jtjtjasontan/Breath_Rate_Estimator/complete_circuit.asc

C1: cap; 100n
C2: cap; 100n
C3: cap; 100n
C4: cap; 100n
C5: cap; 100n
C_Diff: cap; 10µ
CB1: cap; 10µ
R1: res; 10k
R2: res; 10k
R3: res; 470k
R4: res; 100
R5: res; 100
R6: res; 1k
R7: res; 1k
R8: res; 1k
Rdiv1: res; 2.2k
Rdiv2: res; 2.2k
Rdiv3: res; 100
Rdiv4: res; 100
Rdiv5: res; 1k
Rdiv6: res; 1k
Rdiv7: res; 100
RF1: res; 470k
RF2: res; 1k
RF_Diff: res; 100k
RL1: res; 2.2k
RL2: res; 2.2k
Rref1: res; 10k
Rref2: res; 1k
Rubber: res; {R_rubber}
Thermistor: res; {R_therm}
U1: TLV9054
U2: TLV9054
U3: TLV9054
U4: TLV9054
U5: TLV9054
V1: voltage; 3.3
Vref1: voltage; 3.3
Vref2: voltage; 3.3
Named nets: 0, Vcc, V_STM_A0, V_therm, V_rubber, V_STM_A1
.tran 20
Thermistor Signal Conditioning Circuit
Conductive Rubber Signal Conditioning Circuit
Ref. Voltage Divider
Ref. Voltage Divider
Voltage Buffer
Voltage Buffer
Difference Amplifier
Difference Amplifier
Differential Amplifier
Thermistor and Conductive Rubber Setup
