jtjtjasontan/Breath_Rate_Estimator/main.c

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

/* Includes ------------------------------------------------------------------*/
#include "main.h"

/* USER CODE BEGIN Includes */
#include <stdio.h>   /* snprintf */
/* USER CODE END Includes */

ADC_HandleTypeDef hadc1;
TIM_HandleTypeDef htim6;
UART_HandleTypeDef huart2;

/* USER CODE BEGIN PV */
/* Transmission buffer — "4095,4095\r\n" is at most 12 chars */
static char tx_buf[16];
/* USER CODE END PV */

void SystemClock_Config(void);
static void MX_GPIO_Init(void);
static void MX_USART2_UART_Init(void);
static void MX_ADC1_Init(void);
static void MX_TIM6_Init(void);

/* USER CODE BEGIN PFP */
static uint32_t ADC_ReadChannel(uint32_t channel);
/* USER CODE END PFP */

/* USER CODE BEGIN 0 */

/**
  * @brief  Reconfigure ADC1 to the requested channel, perform a single
  *         software-triggered conversion, and return the raw 12-bit result.
  * @param  channel  ADC_CHANNEL_5 or ADC_CHANNEL_6
  * @retval 12-bit ADC result (0–4095)
  */
static uint32_t ADC_ReadChannel(uint32_t channel)
{
    ADC_ChannelConfTypeDef sConfig = {0};

    sConfig.Channel      = channel;
    sConfig.Rank         = ADC_REGULAR_RANK_1;
    sConfig.SamplingTime = ADC_SAMPLETIME_47CYCLES_5; /* longer window for
                                                          high-impedance sources */
    sConfig.SingleDiff   = ADC_SINGLE_ENDED;
    sConfig.OffsetNumber = ADC_OFFSET_NONE;
    sConfig.Offset       = 0;

    if (HAL_ADC_ConfigChannel(&hadc1, &sConfig) != HAL_OK)
    {
        Error_Handler();
    }

    HAL_ADC_Start(&hadc1);

    /* Wait up to 10 ms for conversion to complete */
    if (HAL_ADC_PollForConversion(&hadc1, 10) != HAL_OK)
    {
        HAL_ADC_Stop(&hadc1);
        return 0;
    }

    uint32_t value = HAL_ADC_GetValue(&hadc1);
    HAL_ADC_Stop(&hadc1);

    return value;
}

/* USER CODE END 0 */

/**
  * @brief  Application entry point.
  * @retval int
  */
int main(void)
{
    /* MCU Configuration -------------------------------------------------------*/
    HAL_Init();

    SystemClock_Config();

    MX_GPIO_Init();
    MX_USART2_UART_Init();
    MX_ADC1_Init();
    MX_TIM6_Init();

    /* USER CODE BEGIN 2 */

    /* Run ADC self-calibration for improved accuracy before sampling starts */
    if (HAL_ADCEx_Calibration_Start(&hadc1, ADC_SINGLE_ENDED) != HAL_OK)
    {
        Error_Handler();
    }

    /* Start TIM6 in interrupt mode — HAL_TIM_PeriodElapsedCallback fires
       at 50 Hz (Prescaler = 639, Period = 999, f_clk = 32 MHz):
           f_tim = 32 000 000 / (640 × 1000) = 50 Hz                        */
    if (HAL_TIM_Base_Start_IT(&htim6) != HAL_OK)
    {
        Error_Handler();
    }

    /* USER CODE END 2 */

    /* Infinite loop -----------------------------------------------------------*/
    /* USER CODE BEGIN WHILE */
    while (1)
    {
        /* All work is done inside the TIM6 period-elapsed interrupt callback.
           The main loop intentionally stays empty so the CPU is free to
           service the ISR promptly.                                          */

        /* USER CODE END WHILE */
        /* USER CODE BEGIN 3 */
    }
    /* USER CODE END 3 */
}

/* USER CODE BEGIN 4 */

/**
  * @brief  TIM period-elapsed callback (fires at 50 Hz for TIM6).
  *
  *         Execution timeline per 20 ms window:
  *           1. Read ADC channel 5  (thermistor)
  *           2. Read ADC channel 6  (conductive rubber)
  *           3. Format and transmit "CH5,CH6\r\n" over UART2 @ 115200 baud
  *
  *         Worst-case UART transmission for "4095,4095\r\n" (10 bytes):
  *           10 × (1/115200) × 10 bits ≈ 0.87 ms  — well within 20 ms budget.
  *
  * @param  htim  Pointer to the TIM handle that triggered the callback
  */
void HAL_TIM_PeriodElapsedCallback(TIM_HandleTypeDef *htim)
{
    if (htim->Instance == TIM6)
    {
        /* --- 1. Sample both sensors ----------------------------------------*/
        uint32_t adc_ch5 = ADC_ReadChannel(ADC_CHANNEL_5); /* Thermistor      */
        uint32_t adc_ch6 = ADC_ReadChannel(ADC_CHANNEL_6); /* Conductive rubber*/

        /* --- 2. Format as CSV: "XXXX,XXXX\r\n" ------------------------------*/
        int len = snprintf(tx_buf, sizeof(tx_buf),
                           "%lu,%lu\r\n",
                           (unsigned long)adc_ch5,
                           (unsigned long)adc_ch6);

        /* --- 3. Transmit over UART2 -----------------------------------------*/
        /* Timeout of 5 ms is conservative; actual transfer takes < 1 ms.     */
        HAL_UART_Transmit(&huart2, (uint8_t *)tx_buf, (uint16_t)len, 5);
    }
}

/* USER CODE END 4 */

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
